ruimo/audioswitcher/README.md

# audioswitcher

[Docs](https://ruimo.github.io/audioswitcher/)

# Unit test

./test.sh

# Pic code

Under firmware directory. You can open it by MPLAB IDE X.
