ruimo/audioswitcher/schematics.kicad_sch

## KiCad design schematics.kicad_sch (2023-01-05)

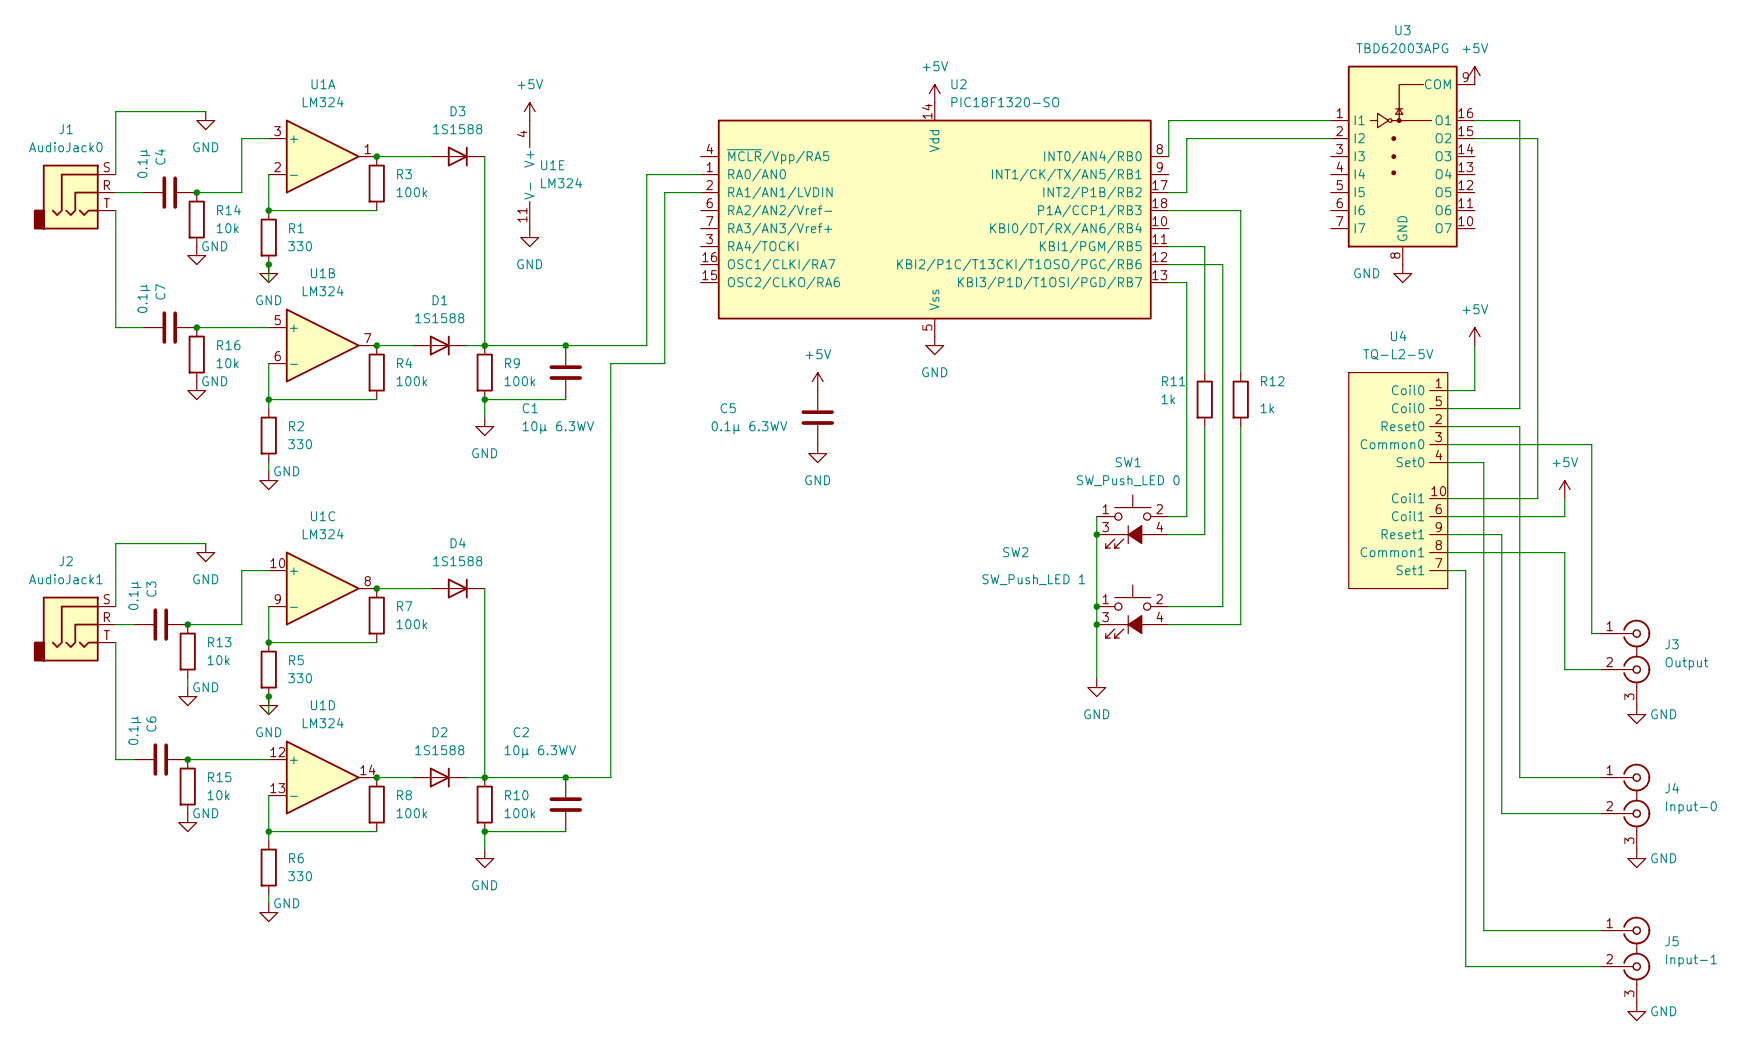
[picture p4: schematic schematics.kicad_sch]

Parts:
C1, C2: 10μ 6.3WV
C3, C4, C6, C7: 0.1μ
C5: 0.1μ 6.3WV
D1, D2, D3, D4: 1S1588
J1: AudioJack0
J2: AudioJack1
J3: Output
J4: Input-0
J5: Input-1
R1, R2, R5, R6: 330
R3, R4, R7, R8, R9, R10: 100k
R11, R12: 1k
R13, R14, R15, R16: 10k
SW1: SW_Push_LED 0
SW2: SW_Push_LED 1
U1: LM324
U2: PIC18F1320-SO; SOIC-18W_7.5x11.6mm_P1.27mm
U3: TBD62003APG
U4: TQ-L2-5V

Connections:
+5V: C5.1, U1.4 (V+), U2.14 (Vdd), U3.9 (COM), U4.1 (Coil0), U4.6 (Coil1)
GND: C1.2, C2.2, C5.2, J1.S, J2.S, J3.3 (EXT), J4.3 (EXT), J5.3 (EXT), R1.2, R2.2, R5.2, R6.2, R9.2, R10.2, R13.2, R14.2, R15.2, R16.2, SW1.1, SW1.3 (K), SW2.1, SW2.3 (K), U1.11 (V-), U2.5 (Vss), U3.8 (GND)
unnamed: C1.1, D1.1 (K), D3.1 (K), R9.1, U2.1 (RA0/AN0)
unnamed: C2.1, D2.1 (K), D4.1 (K), R10.1, U2.2 (RA1/AN1/LVDIN)
unnamed: C3.1, R13.1, U1.10 (+)
unnamed: C3.2, J2.R
unnamed: C4.1, R14.1, U1.3 (+)
unnamed: C4.2, J1.R
unnamed: C6.1, R15.1, U1.12 (+)
unnamed: C6.2, J2.T
unnamed: C7.1, R16.1, U1.5 (+)
unnamed: C7.2, J1.T
unnamed: D1.2 (A), R4.1, U1.7
unnamed: D2.2 (A), R8.1, U1.14
unnamed: D3.2 (A), R3.1, U1.1
unnamed: D4.2 (A), R7.1, U1.8
unnamed: J3.1 (IN1), U4.3 (Common0)
unnamed: J3.2 (IN2), U4.8 (Common1)
unnamed: J4.1 (IN1), U4.2 (Reset0)
unnamed: J4.2 (IN2), U4.9 (Reset1)
unnamed: J5.1 (IN1), U4.4 (Set0)
unnamed: J5.2 (IN2), U4.7 (Set1)
unnamed: R1.1, R3.2, U1.2 (-)
unnamed: R2.1, R4.2, U1.6 (-)
unnamed: R5.1, R7.2, U1.9 (-)
unnamed: R6.1, R8.2, U1.13 (-)
unnamed: R11.1, U2.11 (KBI1/PGM/RB5)
unnamed: R11.2, SW1.4 (A)
unnamed: R12.1, U2.18 (P1A/CCP1/RB3)
unnamed: R12.2, SW2.4 (A)
unnamed: SW1.2, U2.13 (KBI3/P1D/T1OSI/PGD/RB7)
unnamed: SW2.2, U2.12 (KBI2/P1C/T13CKI/T1OSO/PGC/RB6)
unnamed: U2.8 (INT0/AN4/RB0), U3.1 (I1)
unnamed: U2.17 (INT2/P1B/RB2), U3.2 (I2)
unnamed: U3.15 (O2), U4.10 (Coil1)
unnamed: U3.16 (O1), U4.5 (Coil0)
