ruimo/audioswitcher/firmware/device.h

#include <stdbool.h> 
#include <stdint.h>

#ifdef __cplusplus
extern "C" {
#endif

  typedef enum {
    Coil0, Coil1,
  } Coil;

  void turn_on_relay(Coil coil, bool on);

  typedef enum {
    NoButtonPressed, In0Pressed, In1Pressed, BothPressed,
  } ButtonPressed;

  ButtonPressed button_pressed(void);

  typedef enum {
    Led0, Led1,
  } Led;

  void turn_on_led(Led led, bool on);

  bool uart_tx_ready(void);

  void uart_tx(unsigned char c);

  typedef enum {
    Ad0, Ad1,
  } AdPort;

  void start_ad(AdPort port);

  bool get_ad(uint16_t *pValue);

#ifdef __cplusplus
}
#endif
