ruimo/audioswitcher/(commit log)

2023-01-02 abstract device control.
2023-01-02 device test
2023-01-05 Add schematics.
    [schematics.kicad_sch]
